wass1300/BeachBotEcam/Autres/tutoriels/readme.md

Tutoriels
============

Introduction
------------

Les tutoriels sont là pour aider à facilement prendre en main un langage, une portion du robot, la raspberry, une carte annexe, ... Tout le monde est authorisé à créer un tutoriel, mais si vous faites une copie de ceux-ci, n'oubliez pas de mettre les sources. De même, si vous vous inspirez grandement d'internet pour une portion de votre tutoriel, n'hésitez pas à remplir la zone "Credits" de votre tutoriel.

Structure
-----------

Je propose que la structure soit telle que l'on puisse s'y retrouver très rapidement ainsi qu'éviter les majuscules dans les dossiers car nous ne seront pas forcément sur une platerforme "user-friendly" lorsque l'on voudra les lire.

Credits
-----------
Alexis Paques -- Initial commit
