wass1300/BeachBotEcam/Raspberry Pi/multiprocessing/readme.txt

main.py lance 2 process :
- sonar.run()
- path.run()

ensuite les 2 process communiquent entre eux via Queue()

liens interessants :
https://docs.python.org/2/library/multiprocessing.html#exchanging-objects-between-processes
http://stackoverflow.com/questions/8463008/python-multiprocessing-pipe-vs-queue
http://pymotw.com/2/multiprocessing/communication.html
