wass1300/BeachBotEcam/Autres/tutoriels/arduino/readme.md

Tutoriels de l'Arduino Pro Mini
===============================

Ajoutez votre nom aux crédits si vous participez à un des tutoriels de cette branche.

Crédits
--------
Louis Defauw
