wass1300/BeachBotEcam/Autres/tutoriels/raspberrypi/readme.md

Tutoriels de la raspberry
=========================

Ajoutez votre nom aux crédits si vous participez à un des tutoriels de cette branche.

Crédits
--------
Alexis Paques
