wass1300/BeachBotEcam/Autres/tutoriels/raspberrypi/camera/readme.md

Camera
===========

Votre JOB
=========
Via le tutoriel de OpenCV (et/ou Octave), créez un programme permettant de reconnaitre un objet d'une couleur déterminée.

### BONUS

Détectez cet objet à partir d'une couleur HEX du type #45FFCE.

Crédits
-----------
