wass1300/BeachBotEcam/Autres/tutoriels/raspberrypi/communications/uart/readme.md

Uart sur Raspberry en Python
===========================
Introduction
------------
L'UART est un protocole de communication ne permettant pas de base plusieurs esclaves. Pour le faire, nous serions obligés d'ajouter un protocole *Hardcodés* dans les arduinos pour leur définir une adresse personnelle. 

Crédits
--------
Alexis Paques
