wass1300/BeachBotEcam/Autres/rapports/choix arduinos.md

Choix des Arduinos
==================

Nous allons aborder la problématique du choix des arduinos. Celui-ci dépendra principalement du nombre de pins disponible et la tension d'alimentation.

Comparaison entre les modèles intéressants
------------------------------------------

|Nom|Alimentation|In/Out analogique|IO/PWM digital|USB|
|:--:|:--:|:--:|:--:|:--:|
|Uno|5V|6/0|14/6|Regular|
|Leonardo|5V|12/0|20/7|Micro|
|Mega 2560|5V|16/0|54/15|Regular|
|Nano|5V ou 3.3V|6/0|14/6|Mini-B|

Choix en fonction de l'utilisation
----------------------------------

* **Une** Mega 2560 : partie moteur, à cause du nombre de pins digitales utilisées (23 estimées)
* **Deux** Uno ou Leonardo : pour le reste, en fonction du stock

Crédits
=======

Louis Defauw

Alexis Paques

http://arduino.cc/en/Products.Compare
