wass1300/BeachBotEcam/Autres/rapports/Structure des rapports.md

Structure des rapports
======================
Rapport en LATEX suivant le modèle d'Alexis.
Ne faire des commits que des fichiers `.tex`.
Compiler ces fichiers sur votre mochine pour voir le résultat.

Aide disponible sur eole : http://eole.ecam.be/claroline/backends/download.php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.

Partie Gestion (Arnaud, Nabil)
------------------------------

* Contenu défini sur le document disponible sur eole

Partie Technique
----------------

* Architecture (Nabil, Louis)
	+ Structure hardware
	+ Nomenclature
	+ Justifications des choix
* Régulation (Louis, Alexis)
	+ Ultrasons
	+ Roues codeuses
	+ Commande moteur
	+ PWM
* Communication (Alexis)
	+ I²C
	+ RX/TX
* Moteurs (Mounime, Kotati)
	+ Dimensionnement et choix
	+ Driver
	+ Tests
* Chassis (José, Kotati)
* Pince (Nabil)
	+ Dynamixels
	+ Structure (éléments 3D)
* Table et actions du robots (Arnaud, José)
