wass1300/BeachBotEcam/Autres/rapports/LaTeX-Slides/communication.tex

\begin{frame}
\frametitle{Communications}
\framesubtitle{Arduino - Arduino}

\begin{description}
\item[I\up{2}C]
\item Transfert à plusieurs esclaves;
\item Fonction;
\item Données.
\end{description}

\begin{table}[!ht]
	\centering
	\begin{tabular}{|c|c|c|c|}
		\hline
		adresse & fonction & data & data \\
		\hline
		7 bits & 4 bits & 4 bits & 8 bits \\
		\hline
	\end{tabular}
	\caption{Trame I\up{2}C}
	\label{tb:TrameI2C}
\end{table}
\end{frame}

\begin{frame}
\frametitle{Communications}
\framesubtitle{Arduino - DE0nano}
\begin{description}
\item[Direct]
\item Appliquer un prescaler;
\item Transfert d'un signal.
\end{description}
\end{frame}

\begin{frame}
\frametitle{Communications}
\framesubtitle{Arduino - Raspberry Pi}
\begin{description}
\item[SPI/UART]
\item Communication entre 2 cartes;
\item Transfert de données.
\end{description}
\end{frame}
