wass1300/BeachBotEcam/Autres/rapports/LaTeX-Slides/gestion.tex

\begin{frame}
\frametitle{Gestion}
\begin{description}
	\item[Méthode SCRUM] 
	\item Stand-Up meeting avec tournante d'animateur;
	\item Délivrables à court et à long terme;
	\item Travail en binôme la plupart du temps;
	\item Avantages/Inconvénients.
	\item[Git]
	\item Important d'être à jour;
	\item Avantages/Inconvénients.
\end{description}
\end{frame}
