wass1300/BeachBotEcam/Autres/rapports/LaTeX-Slides/perspectives.tex

\begin{frame}
\frametitle{Perspectives}
\begin{description}
\item[OpenCV] Traitement d'image;
\item[Line Tracking] Suiveur d'une ligne;
\item[Pince] Prendre/Bouger/Monter des objets;
\item[Position] Système de position sur la table.
\end{description}
\end{frame}
