wass1300/BeachBotEcam/Autres/rapports/LaTeX-Slides/table_actions.tex

\begin{frame}
\frametitle{Table et actions à réaliser}
\framesubtitle{Table}
\begin{figure}[!ht]
	\centering
	
	\caption{Table}
\end{figure}
\end{frame}

\begin{frame}
\frametitle{Table et actions à réaliser}
\framesubtitle{Action à réaliser}
\begin{itemize}
	\item The spotlight;
	\item The clapperboards;
	\item The popcorn;
	\item Climbing the red carpet steps;
	\item The red carpet.
\end{itemize}
\end{frame}
