wass1300/BeachBotEcam/Autres/codes/arduinos/pwm/lien de rfrence.md

Lien 
-------------------------------------------------------------

http://forum.arduino.cc/index.php?topic=117425.0

Crédits
-------

Mounime Bouzanih
