wass1300/BeachBotEcam/Autres/codes/arduinos/python/lien mega utile.md

Ce site contient une mine d'or d'information pour exploiter la raspberry pi.
C'est là où j'ai trouvé la librairie pigpio que j'utilise pour crée une pwm.

http://abyz.co.uk/rpi/pigpio/examples.html
