wass1300/BeachBotEcam/Autres/rapports/readme.md

Rapports 
========

Ici nous mettrons tous les rapports intérmédiaires et finaux . 

L'idéal serait de faire tous les tutoriels avec la même structure / mise en page. ( Markdown )
