wass1300/BeachBotEcam/Autres/tutoriels/langages/readme.md

Tutoriels des langages
======================

Ajoutez votre nom aux crédits si vous participez à un des tutoriels de cette branche.

Crédits
--------

Alexis Paques

Louis Defauw
