wass1300/BeachBotEcam/Autres/tutoriels/langages/octave/readme.md

Octave
==========
Introduction
-------------
Octave est l'équivalent *libre* de MatLab. Il est un outil surpuissant permettant de faire à peu près n'importe quoi.

Credits
----------
Alexis Paques
