wass1300/BeachBotEcam/Autres/tutoriels/langages/opencv/exemples/README.md

OpenCV sous Python
===================

Presque tout est tiré de http://wiki.labomedia.org/index.php/OpenCV_pour_Python et des exemples fournis directement de l'archive d'OpenCV
