wass1300/BeachBotEcam/Autres/tutoriels/langages/opencv/exemples/videos/Suivi_balle/readme.md

Suivi d'une balle
==================

Ceci est une vidéo très intéressantes donnant les différentes marches à suivre pour faire un suivi d'un objet dans OpenCV. Bien sûr, ce n'est pas du python et il faut l'adapter.

http://www.mon-club-elec.fr/pmwiki_mon_club_elec/pmwiki.php?n=MAIN.OutilsProcessingOpenCVSuiviBalle
