wass1300/BeachBotEcam/Autres/rapports/schema bloc hardware.md

Schéma bloc hardware
====================

Nous avons défini la structure hardware du robot comme suit :

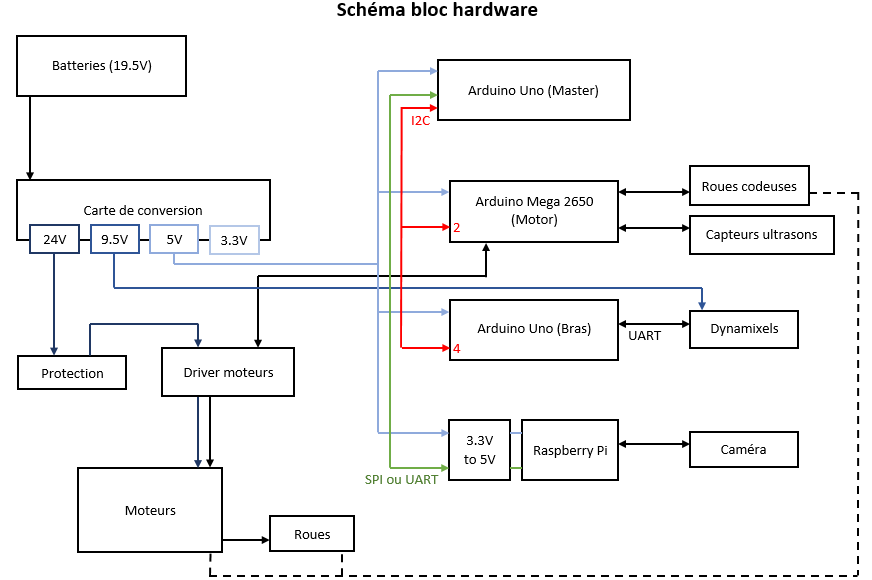
[picture p22: Autres/rapports/hardware.PNG]
Schéma bloc hardware


*Il faut noter que cette vue sera à completer avec l'avancement du projet.*

Crédits
=======

All
