wass1300/BeachBotEcam/Raspberry Pi/main/tasks/tasks.PNG

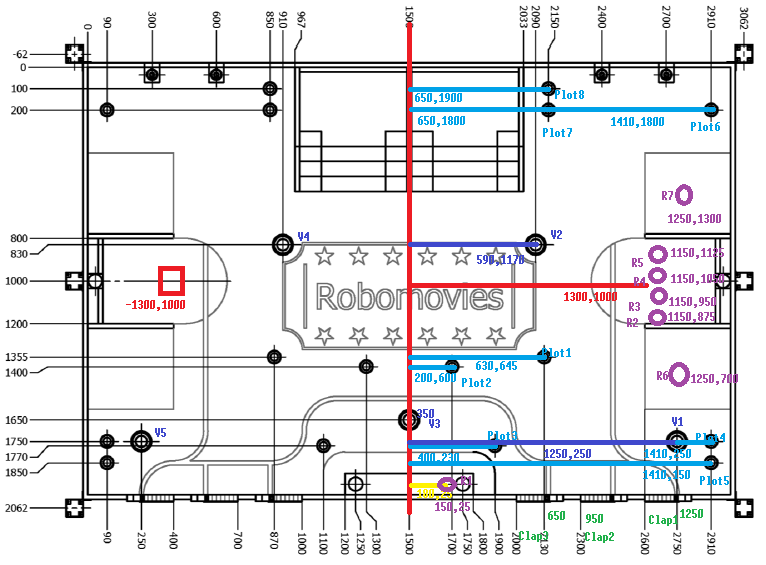
Raspberry Pi/main/tasks/tasks.PNG
