wass1300/BeachBotEcam/Autres/catia/Boitier Ultrason/Drawing1.dxf

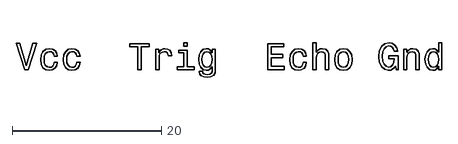
[picture p24: CAD file, 2015-10-20]
Autres/catia/Boitier Ultrason/Drawing1.dxf
57.1 x 4.66
