wass1300/BeachBotEcam/Autres/catia/Boitier Ultrason/box2.stl

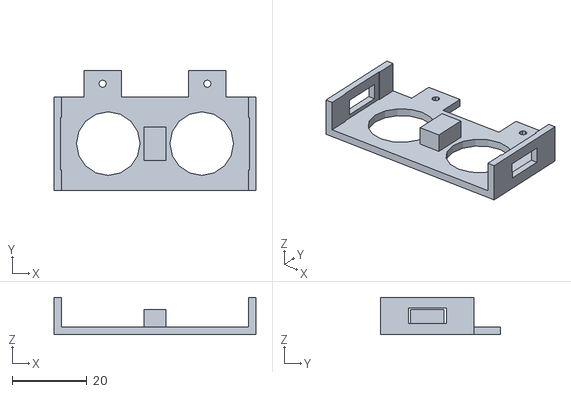
[picture p25: CAD file, 2015-10-20]
Autres/catia/Boitier Ultrason/box2.stl
54.0 x 32.0 x 10.0
