wass1300/BeachBotEcam/Autres/catia/Boitier Ultrason/hcSTP.stp

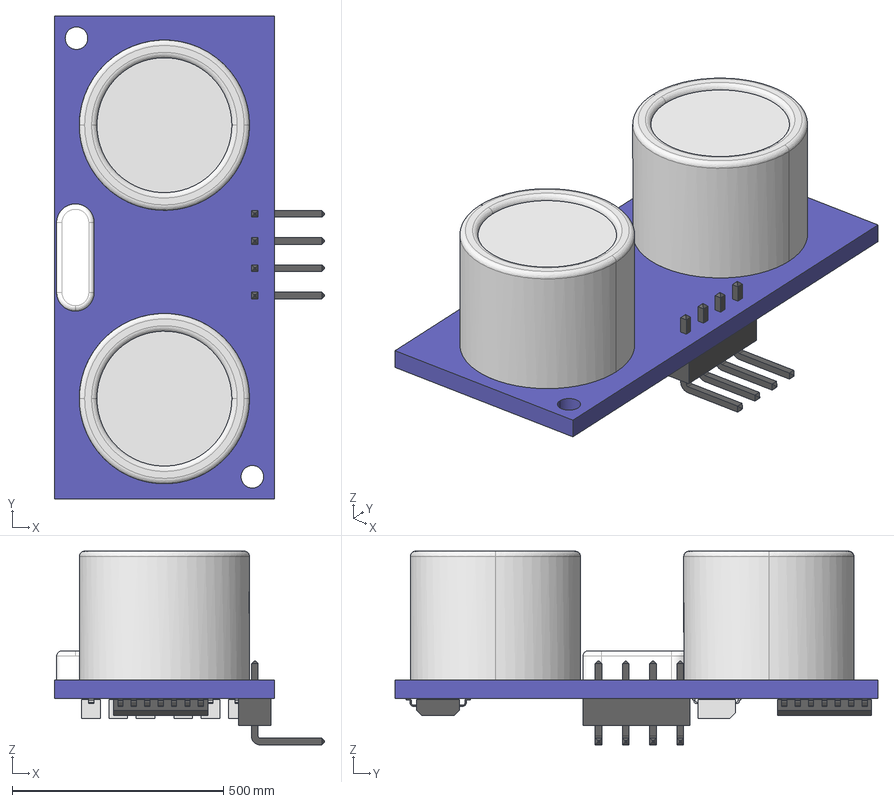
[picture p26: CAD file, 2015-10-20]
Autres/catia/Boitier Ultrason/hcSTP.stp
639.6 x 1143.0 x 458.9 mm
