wass1300/BeachBotEcam/Autres/catia/Boitier Ultrason/box1.stl

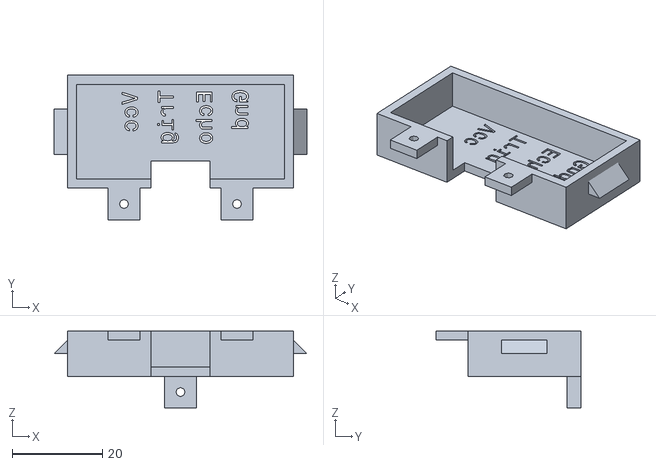
[picture p27: CAD file, 2015-10-20]
Autres/catia/Boitier Ultrason/box1.stl
56.0 x 32.0 x 17.0
