wass1300/BeachBotEcam/(list of files, cad)

Other CAD files:
Autres/catia/Boitier Ultrason/Produit2.CATProduct
Autres/catia/Boitier Ultrason/box1.CATPart
Autres/catia/Boitier Ultrason/box2.CATPart
DE0 nano/simulation/modelsim/rtl_work/clk_div/arch.psm
