wass1300/BeachBotEcam/Autres/tutoriels/raspberrypi/installation/readme.md

Installation de la RaspberryPi
==============================

Credits
------------
