wass1300/BeachBotEcam/(list of files, drawings)

Other design files:
Autres/schema/main.SchDoc
