wass1300/BeachBotEcam/Autres/codes/arduinos/capteurs/ultrason/ultrason.ino

#include <Wire.h>

byte test;

void setup() {
  Wire.begin(9);                // join i2c bus with address #2
  Wire.onRequest(requestEvent); // register event
  pinMode (2,OUTPUT);//attach pin 2 to vcc
  pinMode (5,OUTPUT);//attach pin 5 to GND
  pinMode (6,OUTPUT);
  Serial.begin(9600); 
  // initialize serial communication:
}


void loop()
{
digitalWrite(2, HIGH);
digitalWrite(2,LOW);
  // establish variables for duration of the ping,
  // and the distance result in inches and centimeters:
  long duration, cm;

  // The PING))) is triggered by a HIGH pulse of 2 or more microseconds.
  // Give a short LOW pulse beforehand to ensure a clean HIGH pulse:
  pinMode(3, OUTPUT);// attach pin 3 to Trig
  digitalWrite(3, LOW);
  delayMicroseconds(2);
  digitalWrite(3, HIGH);
  delayMicroseconds(5);
  digitalWrite(3, LOW);

  // The same pin is used to read the signal from the PING))): a HIGH
  // pulse whose duration is the time (in microseconds) from the sending
  // of the ping to the reception of its echo off of an object.
  pinMode (4, INPUT);//attach pin 4 to Echo
  duration = pulseIn(4, HIGH);

  // convert the time into a distance
  cm = microsecondsToCentimeters(duration);
  test = (byte)cm;
  if(cm < 20){
    digitalWrite(6, HIGH);
  }
  else{
    digitalWrite(6, LOW);
  }
  Serial.print(test);
  Serial.print(cm);
  Serial.print("/");
  delay(500);
}

long microsecondsToCentimeters(long microseconds)
{
  // The speed of sound is 340 m/s or 29 microseconds per centimeter.
  // The ping travels out and back, so to find the distance of the
  // object we take half of the distance travelled.
  return microseconds / 29 / 2;
}

void requestEvent()
{
  Wire.write(test);
}
