wass1300/BeachBotEcam/Autres/codes/arduinos/communication/slave/slave.ino

// Wire Slave Sender
// by Nicholas Zambetti <http://www.zambetti.com>

// Demonstrates use of the Wire library
// Sends data as an I2C/TWI slave device
// Refer to the "Wire Master Reader" example for use with this

// Created 29 March 2006

// This example code is in the public domain.


#include <Wire.h>

void setup()
{
  Wire.begin(2);                // join i2c bus with address #2
  Wire.onRequest(requestEvent); // register event
  Wire.onReceive(receiveEvent); 
  Serial.begin(9600);
}

void loop()
{
  delay(100);
}

// function that executes whenever data is requested by master
// this function is registered as an event, see setup()
void requestEvent()
{
  Serial.print("Sending Hello");
  Wire.write("execep qsdqsd");
}

// function that executes whenever data is received from master
// this function is registered as an event, see setup()
void receiveEvent(int howMany)
{
  while(Wire.available()) // loop through all but the last
  {
    byte b = Wire.read(); 
    Serial.print(b);         // print the byte
    Serial.print(" ");
  }
  Serial.print("\n");
}
