wass1300/BeachBotEcam/Arduino Moteurs/tests/integration/I2CBusMaster.h

/* 
  I2CBusMaster.h : Master code for a lightbus on Arduino
  V-0.0.1 Copytight (C) 2014 Alexis Paques
  written and in test for Arduino Duo
  
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
*/

#include "Arduino.h"
#include <SPI.h>
#ifndef I2CBusMaster_h
#define I2CBusMaster_h

class I2CBusMaster
{
  public:
    I2CBusMaster();
    byte inBuffer[2];
    void Begin();
    void Send(byte adress, byte function, byte data = 0);
    void Request(byte adress); 
  private:
    inline void Flush();
};

#endif
