wass1300/BeachBotEcam/(commit log)

2015-11-11 Add a new test for I2C communication
2015-11-12 Ajout des commandes de moteur pour Driver
2015-11-12 Modification des Ajouts de commande moteurs (commentaires des commandes)
2015-11-13 Distinction entre le test de l'I2C en debug et en commande moteur
2015-11-16 Rectification de l'agencement des fichiers script dans les dossiers : TestI2C
2015-11-17 Agencement des dossiers pour Test I2C
2015-11-19 Ajout de commantaires + simplification
2015-11-19 Suppression de lignes inutiles
2016-02-23 Test des différentes commandes moteur
